gmrozek-mchp/wigwag/hardware/kicad/wigwag.kicad_sch

## KiCad design hardware/kicad/wigwag.kicad_sch (2026-08-15)

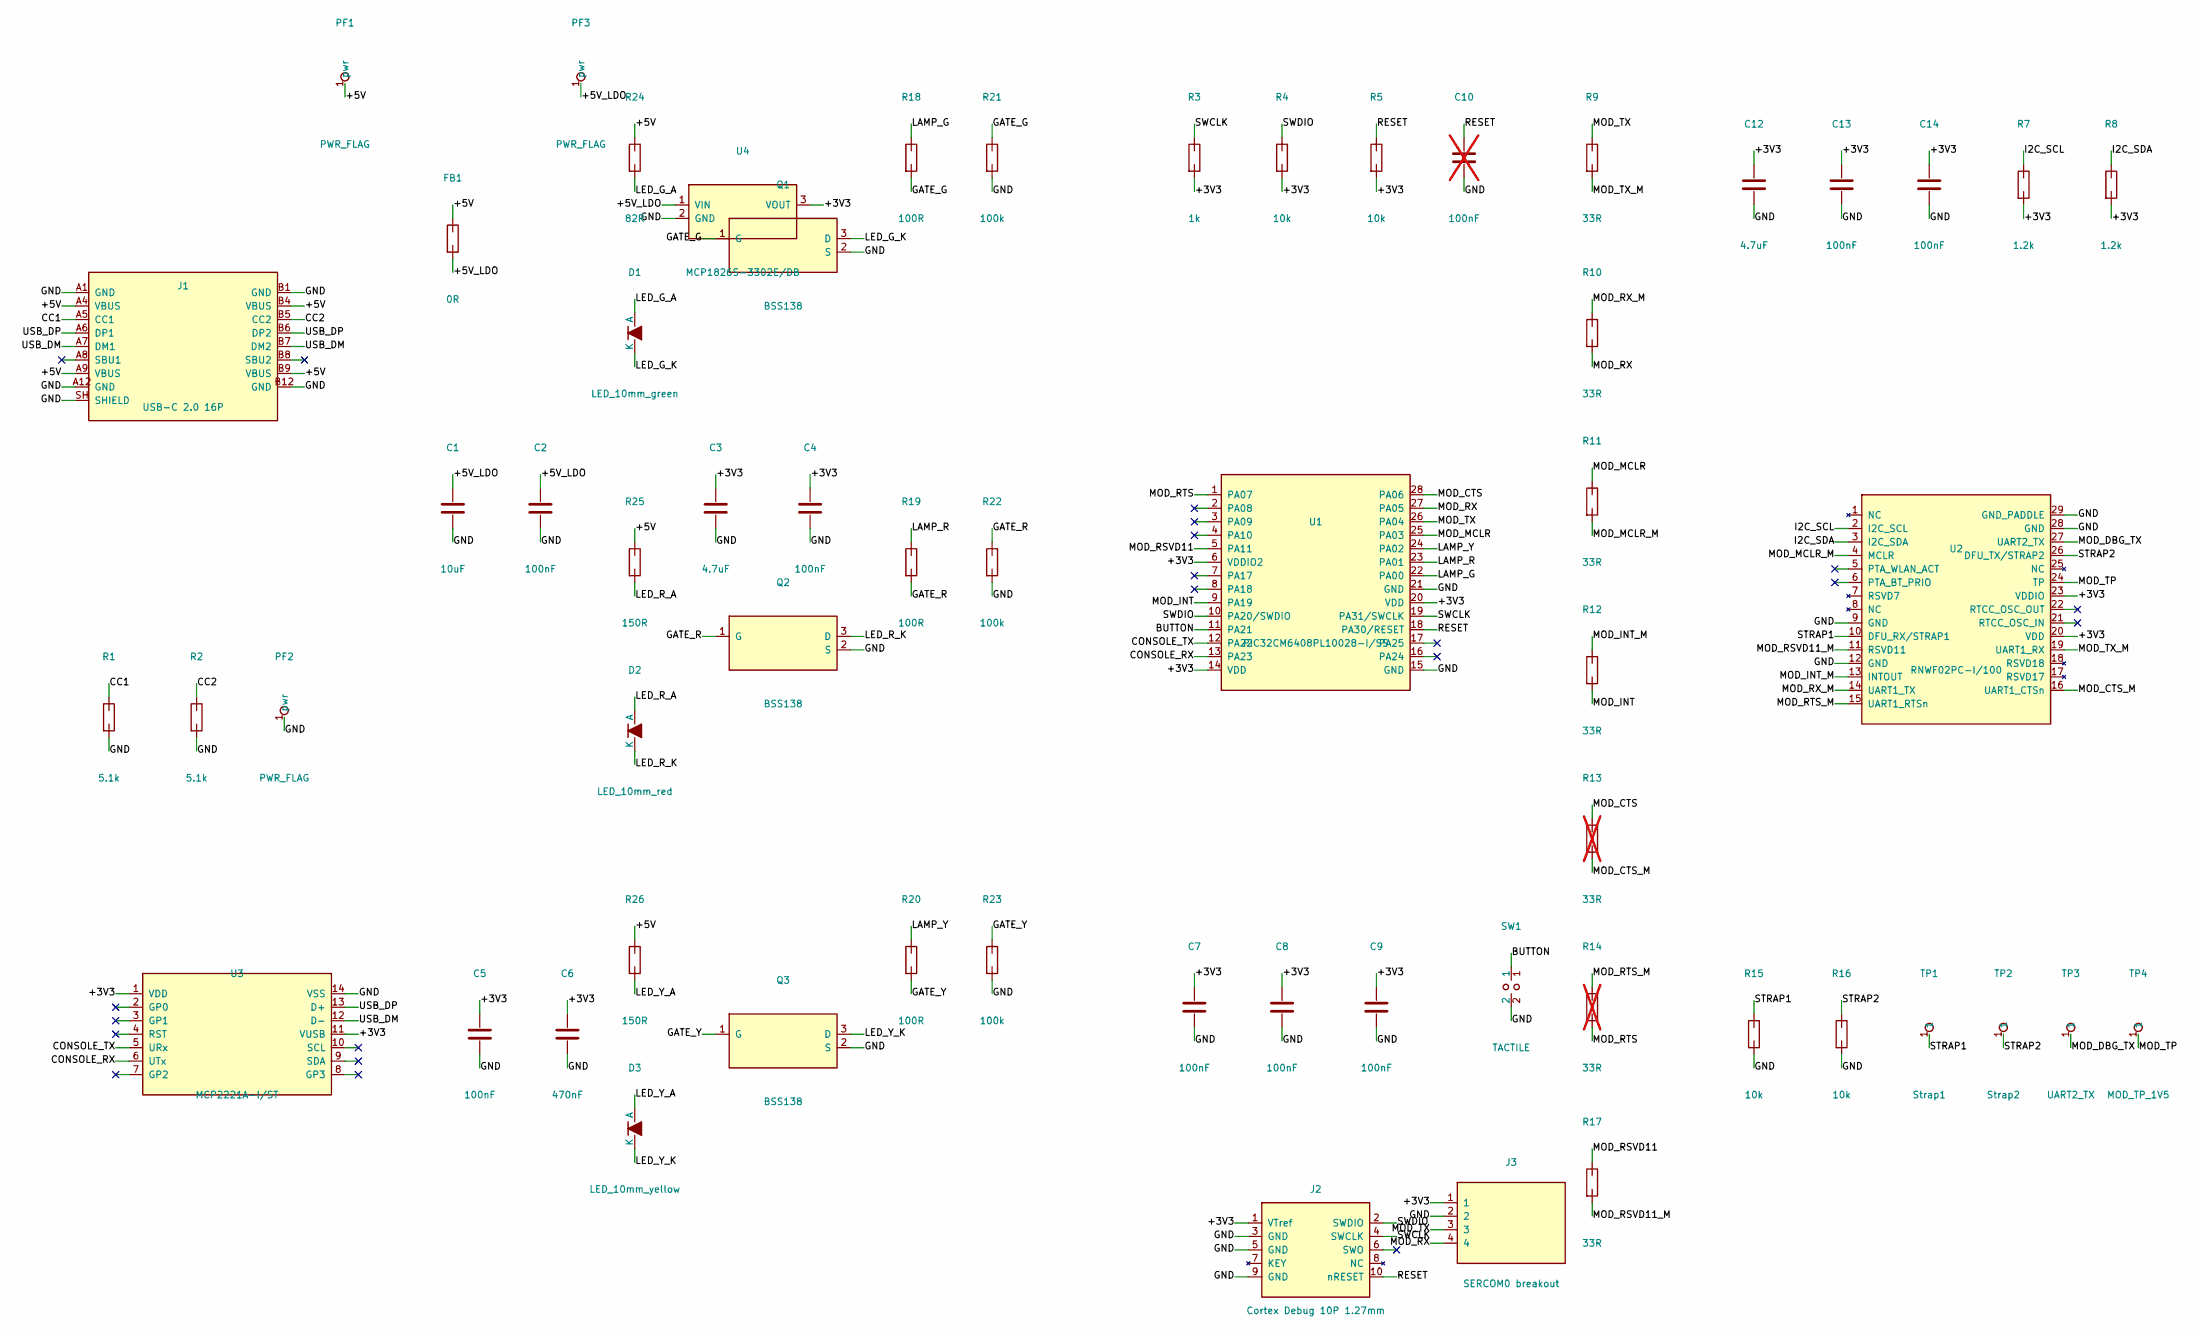
[picture p1: schematic wigwag.kicad_sch]

Parts:
C1: 10uF; C_1206_3216Metric
C2, C4, C5, C7, C8, C9, C13, C14: 100nF; C_0402_1005Metric
C3: 4.7uF; C_0805_2012Metric
C6: 470nF; C_0402_1005Metric
C10: 100nF; C_0402_1005Metric; not fitted
C12: 4.7uF; C_1206_3216Metric
D1: LED_10mm_green; LED_D10.0mm
D2: LED_10mm_red; LED_D10.0mm
D3: LED_10mm_yellow; LED_D10.0mm
FB1: 0R; R_0805_2012Metric
J1: USB-C 2.0 16P; USB_C_Receptacle_GCT_USB4105-xx-A_16P_TopMnt_Horizontal
J2: Cortex Debug 10P 1.27mm; PinHeader_2x05_P1.27mm_Vertical
J3: SERCOM0 breakout; PinHeader_1x04_P2.54mm_Vertical
PF1, PF2, PF3: PWR_FLAG
Q1, Q2, Q3: BSS138; SOT-23
R1, R2: 5.1k; R_0402_1005Metric
R3: 1k; R_0402_1005Metric
R4, R5, R15, R16: 10k; R_0402_1005Metric
R7, R8: 1.2k; R_0402_1005Metric
R9, R10, R11, R12, R17: 33R; R_0402_1005Metric
R13, R14: 33R; R_0402_1005Metric; not fitted
R18, R19, R20: 100R; R_0402_1005Metric
R21, R22, R23: 100k; R_0402_1005Metric
R24: 82R; R_0805_2012Metric
R25, R26: 150R; R_0805_2012Metric
SW1: TACTILE; SW_PUSH_6mm
TP1: Strap1; TestPoint_Pad_D1.5mm
TP2: Strap2; TestPoint_Pad_D1.5mm
TP3: UART2_TX; TestPoint_Pad_D1.5mm
TP4: MOD_TP_1V5; TestPoint_Pad_D1.5mm
U1: PIC32CM6408PL10028-I/SS; SSOP-28_5.3x10.2mm_P0.65mm
U2: RNWF02PC-I/100; RNWF02PC_Module
U3: MCP2221A-I/ST; TSSOP-14_4.4x5mm_P0.65mm
U4: MCP1826S-3302E/DB; SOT-223-3_TabPin2

Connections:
+3V3: C3.1, C4.1, C5.1, C6.1, C7.1, C8.1, C9.1, C12.1, C13.1, C14.1, J2.1 (VTref), J3.1, R3.2, R4.2, R5.2, R7.2, R8.2, U1.6 (VDDIO2), U1.14 (VDD), U1.20 (VDD), U2.20 (VDD), U2.23 (VDDIO), U3.1 (VDD), U3.11 (VUSB), U4.3 (VOUT)
+5V: FB1.1, J1.A4 (VBUS), J1.A9 (VBUS), J1.B4 (VBUS), J1.B9 (VBUS), PF1.1, R24.1, R25.1, R26.1
+5V_LDO: C1.1, C2.1, FB1.2, PF3.1, U4.1 (VIN)
BUTTON: SW1.1, U1.11 (PA21)
CC1: J1.A5 (CC1), R1.1
CC2: J1.B5 (CC2), R2.1
CONSOLE_RX: U1.13 (PA23), U3.6 (UTx)
CONSOLE_TX: U1.12 (PA22), U3.5 (URx)
GATE_G: Q1.1 (G), R18.2, R21.1
GATE_R: Q2.1 (G), R19.2, R22.1
GATE_Y: Q3.1 (G), R20.2, R23.1
GND: C1.2, C2.2, C3.2, C4.2, C5.2, C6.2, C7.2, C8.2, C9.2, C10.2, C12.2, C13.2, C14.2, J1.A1 (GND), J1.A12 (GND), J1.B1 (GND), J1.B12 (GND), J1.SH (SHIELD), J2.3 (GND), J2.5 (GND), J2.9 (GND), J3.2, PF2.1, Q1.2 (S), Q2.2 (S), Q3.2 (S), R1.2, R2.2, R15.2, R16.2, R21.2, R22.2, R23.2, SW1.2, U1.15 (GND), U1.21 (GND), U2.9 (GND), U2.12 (GND), U2.28 (GND), U2.29 (GND_PADDLE), U3.14 (VSS), U4.2 (GND)
I2C_SCL: R7.1, U2.2 (I2C_SCL)
I2C_SDA: R8.1, U2.3 (I2C_SDA)
LAMP_G: R18.1, U1.22 (PA00)
LAMP_R: R19.1, U1.23 (PA01)
LAMP_Y: R20.1, U1.24 (PA02)
LED_G_A: D1.1 (A), R24.2
LED_G_K: D1.2 (K), Q1.3 (D)
LED_R_A: D2.1 (A), R25.2
LED_R_K: D2.2 (K), Q2.3 (D)
LED_Y_A: D3.1 (A), R26.2
LED_Y_K: D3.2 (K), Q3.3 (D)
MOD_CTS: R13.1, U1.28 (PA06)
MOD_CTS_M: R13.2, U2.16 (UART1_CTSn)
MOD_DBG_TX: TP3.1, U2.27 (UART2_TX)
MOD_INT: R12.2, U1.9 (PA19)
MOD_INT_M: R12.1, U2.13 (INTOUT)
MOD_MCLR: R11.1, U1.25 (PA03)
MOD_MCLR_M: R11.2, U2.4 (MCLR)
MOD_RSVD11: R17.1, U1.5 (PA11)
MOD_RSVD11_M: R17.2, U2.11 (RSVD11)
MOD_RTS: R14.2, U1.1 (PA07)
MOD_RTS_M: R14.1, U2.15 (UART1_RTSn)
MOD_RX: J3.4, R10.2, U1.27 (PA05)
MOD_RX_M: R10.1, U2.14 (UART1_TX)
MOD_TP: TP4.1, U2.24 (TP)
MOD_TX: J3.3, R9.1, U1.26 (PA04)
MOD_TX_M: R9.2, U2.19 (UART1_RX)
RESET: C10.1, J2.10 (nRESET), R5.1, U1.18 (PA30/RESET)
STRAP1: R15.1, TP1.1, U2.10 (DFU_RX/STRAP1)
STRAP2: R16.1, TP2.1, U2.26 (DFU_TX/STRAP2)
SWCLK: J2.4 (SWCLK), R3.1, U1.19 (PA31/SWCLK)
SWDIO: J2.2 (SWDIO), R4.1, U1.10 (PA20/SWDIO)
USB_DM: J1.A7 (DM1), J1.B7 (DM2), U3.12 (D-)
USB_DP: J1.A6 (DP1), J1.B6 (DP2), U3.13 (D+)
