gmrozek-mchp/wigwag/(commit log)

2026-08-14 Phase 0: project scaffold, journaling workflow, and nine ADRs
    wigwag is a Wi-Fi desk stoplight that shows AI coding session state:
    green idle, yellow working, red waiting on you. Microchip silicon,
    Zephyr RTOS, custom PCB, 3D-printed enclosure.
    No code yet — this establishes the documentation practice first, which
    was the project's stated first rule.
    Documentation structure (ADR-0005):
    - JOURNAL.md append-only devlog, newest first
    - docs/adr/ one durable decision per numbered file
    - CONTEXT.md ubiquitous language; states are IDLE/BUSY/WAIT/ERROR
    - CLAUDE.md five standing rules for AI-assisted sessions
    - docs/PLAN.md the plan plus a D01-D51 decision register
    Reusable journal sk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
2026-08-14 Phase 1: host daemon, CLI, and cross-platform hook client
    Claude Code hooks -> wg-notify -> wigwagd -> MQTT broker -> the light.
    93 tests, no hardware required.
    Two added requirements invalidated parts of the approved plan:
    Cross-platform. The plan's AF_UNIX datagram socket does not exist on
    Windows, and its `sh` + `nc` client is unusable (no nc in Git Bash, and
    incompatible flags across netcat variants). Replaced with loopback UDP
    and a shell client using bash's built-in /dev/udp: no jq, sed, nc,
    Python or Node in the hook path, measured at 2.9 ms median / 3.7 ms p95.
    UDP also makes Rule 3 structural rather than careful, since sendto on a
    connectionless socket cannot block or fail when th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
    [__main__.py, cli.py, config.py, daemon.py, listener.py, paths.py, protocol.py, publisher.py]
2026-08-14 ADR-0013: the broker address is configured, not auto-discovered
    Resolves D60, left open by ADR-0012.
    DNS-SD does register service names for this — _mqtt._tcp (1883) and
    _secure-mqtt._tcp (8883) — but neither end of this system speaks it,
    and both were verified rather than assumed:
    - RNWF02 has no mDNS. Its network features are listed identically in
    the datasheet and sell sheet: TCP, UDP, DHCP, ARP, HTTP, MQTT,
    IPv4/IPv6, TLS 1.2, DNS, SNTP.
    - mosquitto does not advertise: no mDNS/avahi symbols in the binary,
    and a live `dns-sd -B _mqtt._tcp local` browse returned nothing.
    Two naming collisions kept distinct in the ADR, since both mislead:
    Harmony 3's TCPIP_MDNS_ServiceRegister b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
2026-08-14 Phase 2: Zephyr workspace, and D49 TCC0 PWM passes on hardware
    Pinned minimal west workspace with its top directory at the repo root
    (ADR-0014): mainline at an explicit SHA per ADR-0006, a four-module
    name-allowlist, and the arm-zephyr-eabi toolchain only. ~1 GB of tree and one
    toolchain rather than several gigabytes of both.
    D49, the spike gating the PCB, passes in devicetree alone. Mainline has the
    driver and the binding, but the PL10 devicetree defines no TC or TCC node at
    all, so nothing bound. firmware/boards/pic32cm_pl10_cnano.overlay adds TCC0,
    its generic-clock channel and its pinctrl group; no driver work, no patch to
    the pinned tree, no Zephyr4Microchip fallback.
    Verified on an E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
    [main.c]
2026-08-14 Capture the RNWF02 AT wire vocabulary, verified from the specification
    firmware/src/rnwf_at_cmds.h holds every command string, parameter ID and
    length limit the firmware needs, each cited to the AT Command Specification,
    Network Controller 3.1.0, Revision 58a15dc2, August 19 2025.
    Needed because the MCP documentation tools cannot see that specification at
    all: MQTT queries return only the Harmony 3 C wrapper, which documents
    semantics and no wire text. Deliberately not derived from the RNWF11 guide's
    inline AT reference either - assuming a sibling module's command set is how a
    plausible fiction gets encoded, and a fake module built on one would pass its
    own tests while proving nothing.
    Fou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
2026-08-14 AT client core, with host tests that need neither Zephyr nor hardware
    firmware/src/rnwf_at.{h,c}: line assembler, request/response engine, AEC
    dispatch, connect state machine with capped exponential backoff, publish. No
    Zephyr headers, no allocation, one bounded buffer per direction.
    The connect sequence is a script - an array of steps, each with a command
    builder and an optional AEC to await - rather than a state per command. That
    makes the specification's most dangerous rule structural instead of remembered:
    OK means accepted, not done, so a step that awaits an AEC does not advance when
    OK arrives. A builder returning 0 means "skip me", which handles NULL
    credentials and open networks wit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
    [rnwf_at.c, rnwf_at.h]
2026-08-14 Fake RNWF02 module and host runner: end-to-end AT client, no hardware
    firmware/sim/fake_rnwf02.py speaks the AT protocol on a PTY or serial port and
    bridges MQTT to a real broker. Framing is faithful to the specification,
    including the leading CR on every AEC and the rule that AECs queue behind a
    command in flight rather than interleaving with it. Failure injection covers
    what a real module will never do on demand: --no-connack, --connack-reason,
    --fail <PREFIX>, --drop-link-after, --slow.
    firmware/sim/at_host.c drives the real rnwf_at.c over that PTY via
    "make -C firmware/tests sim". Together these are the native_sim substitute
    ADR-0015 promised, and they work on macOS.
    Verified against a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
    [at_host.c, fake_rnwf02.py, rnwf_at.c, rnwf_at.h]
2026-08-14 Fix inverted lamp polarity, and the binding bug that made the fix a no-op
    The Curiosity Nano's LED0 is active low - user guide Table 4-1 and section
    4.1, "driving the connected I/O line to GND will activate the LED" - while
    mainline's pic32cm_pl10_cnano.dts declares it GPIO_ACTIVE_HIGH. The D49 lamp
    had therefore been running inverted, and neither blinky nor a symmetric fade
    can reveal that, since an inverted triangle is still a triangle. The cubic
    gamma ramp is what distinguishes the two: with the wrong polarity the lamp sat
    lit with a brief dark dip, the exact inverse of a breath.
    Adding PWM_POLARITY_INVERTED changed the generated devicetree but produced a
    byte-identical binary, which pyO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
    [main.c]
2026-08-14 Document how to upstream the two Zephyr bugs found in Phase 2
    docs/upstreaming-to-zephyr.md captures the submission process so it does not
    have to be re-derived: issue first, fork, git commit -s with a legal name,
    subject under 72 characters, mandatory body even for a one-liner, Fixes #N,
    rebase rather than fixup. Read from the Zephyr contribution docs rather than
    recalled, with the pages cited.
    Also records what routing and evidence a reviewer will want: both files sit in
    the MAINTAINERS.yml "Microchip PIC32 Platforms" area; the binding rename is safe
    because pwm-cells are positional and nothing in tree reads the cell by name; and
    the four in-tree users of those bindings are unaffected. Re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
2026-08-14 SERCOM0 transport: the AT client now runs the full script on silicon
    Enables SERCOM0 as the module UART in the board overlay - pinctrl group,
    gclkperiph channel, microchip,sercom-g1-uart node - behind a wigwag,module-uart
    chosen node so the AT client never names a board-specific label. PA04 is PAD0
    (TX) and PA05 is PAD1 (RX), mux C, chosen by elimination: the debugger holds
    PB00/PB01, PA20, PA31, PB03 and PA30; PA24/PA25 are the crystal footprint;
    PB08/PB09 the touch button; and PA08-PA15 sit in the MVIO domain (D76).
    firmware/src/rnwf_uart.{h,c} is the Zephyr half of struct rnwf_at_io:
    interrupt-driven receive into a 256-byte static ring drained in thread context,
    polled transmit. Polled r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
2026-08-14 link.c: supervise the link so the device cannot confidently lie
    Built before lamp.c on purpose. Until supervision exists a renderer can only
    produce a confident display of something nobody is confirming, so building the
    lamps first would have meant building the ability to lie and then fixing it.
    Reading +MQTTCONN:<CONN_STATE> - the last unread part of the AT specification -
    made the structure clear. There are three independent ways to lose the truth and
    no single signal covers them:
    module or UART dies nothing arrives keepalive AT goes unanswered
    broker or Wi-Fi lost module still healthy module reports +MQTTCONN:0
    host daemon dies module and broker ok wigwag/host_onlin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
    [link.c, link.h, main.c, rnwf_at.c, rnwf_at.h, rnwf_at_cmds.h]
2026-08-14 Measure stack utilisation, and tune the ISR stack on the evidence
    Stack sizes were the one part of this budget chosen by feel, which Rule 5 asks
    us not to do. firmware/prj_stacks.conf is a measurement-only overlay:
    CONFIG_THREAD_ANALYZER selects CONFIG_INIT_STACKS, which fills every stack with
    0xaa before use - threads and the interrupt stack alike - and the analyzer walks
    each one to find where the pattern stops. Output goes through printk so it does
    not drag in the logging subsystem, and CONFIG_THREAD_NAME is enabled because
    without it the report prints thread-object addresses instead of names.
    Peaks after an exercise covering the connect script, every lamp behaviour, an
    unparseable paylo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
2026-08-14 Three lamps: CONTEXT.md's table becomes executable, and two faults found doing it
    lamp.c holds the animation as pure logic - (state, link condition, time) ->
    three perceptual levels, plus a state parser and the gamma curve - with
    lamp_pwm.c as the Zephyr renderer owning PWM, per-lamp polarity and a render
    thread. Same core/adapter split as rnwf_at.c against rnwf_uart.c, so every
    behaviour in CONTEXT.md's lamp table is asserted on the host: 511 checks,
    bringing the three suites to 1407.
    Pins on the Curiosity Nano, by elimination: green on WO0/PA24, red on WO1/PA25,
    yellow on WO2/PB02 which is the board's own LED. PA24/PA25 are the 32.768 kHz
    crystal's I/O lines, which the board routes to the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
2026-08-14 button.c: publish presses, and the device talks back for the first time
    button.c is pure debounce and press classification - 20 ms settling, duration
    measured between debounced edges, long-hold threshold at 3 s - with
    button_gpio.c as a polled pin read. test_button.c adds 23 checks; four suites
    now total 1430.
    Polled rather than interrupt-driven, which deviates from plan item 17's "GPIO
    IRQ" (D86). The GPIO driver does support interrupts, but only through
    CONFIG_INTC_MCHP_EIC_G1, and PL10's devicetree has no eic node - the driver and
    binding exist and the JH, SG and SAM families instantiate it, but this family
    does not. The same three-layer gap as TCC0. Polling wins on merit anyway: a
    press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
    [button.c, button.h, button_gpio.c, button_gpio.h, main.c]
2026-08-14 Brightness in two layers: preference over MQTT, calibration in devicetree
    Asked whether brightness should be one value or per bulb; it is both, at
    different layers, because they are different problems. wigwag/brightness is
    runtime preference - "too bright for my desk at night" - carried retained over
    MQTT as CONTEXT.md specifies. Per-lamp gain is calibration, a fixed property of
    a board and its parts, sitting in devicetree beside polarity. LEDs of different
    colours are not equally efficient at the same duty, so equal perceptual levels
    do not look equally bright.
    Sharing one mechanism would give the worst of both: calibration clobbered
    whenever somebody dims the device for the evening, and a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
    [lamp.c, lamp.h, lamp_pwm.c, lamp_pwm.h, main.c, rnwf_at.c, rnwf_at.h]
2026-08-15 Publish wigwag/online, and verify the Last Will actually fires
    main.c publishes 1 retained to wigwag/online once per connection, closing the
    last gap in CONTEXT.md's topic table. AT+MQTTLWT had registered 0 as the will
    since the AT client was written, but a will with no positive counterpart is
    useless: a subscriber cannot distinguish "never seen" from "connected", because
    both look like an absent topic.
    Keyed on the AT client reaching READY, deliberately not on the link condition.
    This topic means "connected to the broker", which stays true when the host daemon
    dies; publishing 0 then would be the device misreporting itself because somebody
    else went away. wigwag/online is the device's own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
    [main.c]
2026-08-15 firmware: watchdog that only feeds when every task is alive
    Both the AT service loop and the render thread must check in within
    500 ms or the device stops feeding and the WDT reboots it 2 s later.
    Feeding from one loop would have certified half the system while
    silently vouching for the other half: the render thread could die
    with the lamps frozen on a stale state and the watchdog would keep
    the device up indefinitely. Demonstrated on hardware by wedging the
    render thread deliberately. ADR-0016, D93-D95.
    Liveness accounting is pure logic in wdog.c, host-tested (6159
    checks); wdog_wdt.c holds the peripheral and the reset-cause report.
    Adds the wdt and rstc devicetree nodes PL10 lacks.
    CON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
    [lamp_pwm.c, main.c, wdog.c, wdog.h, wdog_wdt.c, wdog_wdt.h]
2026-08-15 firmware: flash driver for PL10's NVMCTRL, as a Zephyr module
    Mainline has no flash driver for PIC32CM PL, and its two Microchip
    drivers target other peripheral revisions: nvmctrl-g1-flash names
    module U2409 and drives a page buffer with PBC/EB, which this
    revision does not have. Written from the datasheet sequence
    (26.4.2.3.4) and verified on a pic32cm_pl10_cnano.
    Shipped as an out-of-tree module rather than a patch to the pinned
    tree, since west update reverts patches silently, and because this
    shape upstreams as a file move. ADR-0017, D96-D99.
    The subtlety worth knowing: issuing an enable command such as FLWR
    or FLPER is itself a command that clears INTFLAG.READY, and storing
    to the a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
2026-08-15 Fit an MCP2221A, and run one transport at a time
    Decides the two questions left open yesterday. The MCP2221A goes on
    the USB-C connector ADR-0009 already puts on the board for power with
    D+/D- unconnected, so the delta is one TSSOP-14, two caps and two
    pins -- it carries its own oscillator and USB termination.
    That preserves the console on the product. Not a new capability: the
    Curiosity Nano's debugger already supplies a CDC console and the
    firmware has been built assuming one. The point is that it would
    silently disappear on a board with no debugger attached, leaving SWD
    as the only route to RESET BY WATCHDOG, NOT FEEDING, link UNLINKED
    and the D74 PWM flags. Carrying it over is a dev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
2026-08-15 firmware: configure the device over the console
    Changing a Wi-Fi password needed a rebuild and a probe (D56). Now the
    network, broker, per-lamp calibration and brightness are set over the
    console and stored in the partition ADR-0017's flash driver made
    writable; Kconfig supplies defaults only. ADR-0019, D105-D110.
    Hand-rolled in three layers so the editing half can be replaced:
    lineedit.c (bytes -> lines, injected output callback, no Zephyr),
    cmd.c (vocabulary and validation), console.c (effects). Zephyr's
    shell was measured and does not link on this part -- RAM overflowed
    by 464 bytes, ~4 KB against 3624 free -- and embedded-cli was
    assessed and declined. Backspace kept; arrow keys mad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
    [cmd.c, cmd.h, console.c, console.h, lamp.c, lamp.h, lamp_pwm.c, lamp_pwm.h]
2026-08-15 firmware: one transport at a time, chosen from evidence
    Implements D104. transport.c sits above link.c: link.c answers "is the
    Wi-Fi path trustworthy", transport.c answers "which path is the device
    listening to, and may it be believed". The lamps follow the transport,
    so a trusted USB host outranks a healthy Wi-Fi link and a quiet USB
    host goes fail-visible even while Wi-Fi is up.
    Checking the daemon first turned up the reason the wired path needs
    something MQTT does not: host_online is published once, retained, with
    0 as the Last Will, so the broker holds the value and reports the
    death. A serial line has neither, and USBCFG cannot help because a
    machine whose daemon crashed still enume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
    [cmd.c, cmd.h, console.c, console.h, main.c, transport.c]
2026-08-15 host: publish over a serial wire, not just a broker
    Completes D111, which was device-side only. A SerialPublisher sits
    behind the Publisher protocol the daemon already had, so a device wired
    to this machine needs no broker, no Wi-Fi credentials and no
    provisioning. Verified end to end: hook UDP -> daemon -> serial ->
    device, with the device reporting `transport usb TRUSTED`.
    pyserial on every platform rather than termios on POSIX and pyserial on
    Windows. A split backend puts the untested path on the platform we
    cannot casually debug, and saves nothing since Windows needs the
    dependency either way. Optional extra, imported lazily, so the test
    suite and pure logic still run with nothing i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
    [__main__.py, config.py, publisher.py]
2026-08-15 firmware: the USB claim latches until reset
    Supersedes ADR-0018's transport-selection mechanics and its
    USBCFG/SSPND pin decision. ADR-0021, D117, D118; D112 superseded.
    The soft hold treated the two transports as interchangeable carriers of
    one truth. They are not: a daemon aggregates the sessions of its own
    machine (D30), so falling back from USB to Wi-Fi does not restore the
    display -- it silently changes the subject from "what is my laptop
    doing" to "what is some other machine doing", with nothing on a
    three-lamp device to mark the swap. Amber is the more honest answer.
    So once a host has spoken over the wire, the device belongs to USB for
    the rest of the boot. Trust still tracks t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
    [cmd.c, cmd.h, console.c, main.c, transport.c, transport.h]
2026-08-15 host: report the transport in use, not the broker
    `wigwag status` printed "broker localhost:1883 (plain)" while
    publishing over a serial wire, and `wigwag config` printed broker
    settings -- and broker warnings -- for a device that had no broker. A
    status display that misdescribes the system invites debugging the wrong
    half of it.
    The snapshot now carries a `transport` label taken from the live
    configuration, and the config printer shows only the transport in use.
    Found by bringing the whole stack up against real Claude Code hook
    events rather than synthetic datagrams, which the journal entry
    records: both paths carried this session's own state, and an
    accidentally stale `broker mqtt.home.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
    [cli.py, daemon.py]
2026-08-15 firmware: the transport is configured, not inferred
    Supersedes ADR-0021 outright and the rest of ADR-0018's selection
    decision. ADR-0022, D119, D120; D104, D112 and D117 superseded, D103
    withdrawn.
    Selection was inference (D104), then inference plus a latch (D117).
    Both let a cable plugged in for power or configuration silently
    repurpose the device, and the latch made it irreversible as well as
    surprising. The mistake in both was treating the choice as something
    to detect: ADR-0013 had already settled this shape for the broker
    address -- configured, not auto-discovered -- and this should have
    followed it.
    So `set transport usb|wifi`, stored, shown first by `show` because it
    decides what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
    [cmd.c, cmd.h, console.c, main.c, settings.c, settings.h, settings_store.c]
2026-08-15 firmware: test wifi before committing to it, and a real wigwag
    Two changes that turned out to be connected. D121, D122.
    `test wifi` runs the connect script against the stored settings on a
    device that is still wired, names the step it reaches, and leaves the
    transport setting and the lamps alone. Previously the only way to test
    Wi-Fi was `set transport wifi`, `save`, `reboot`, and then staring at a
    device that would not say why it failed. rnwf_at.c's script table
    gained a name per step, so a wrong passphrase fails at "associate and
    get an IP", a wrong broker at "resolve, connect and CONNACK", and a
    miswired module at "module responding".
    It runs asynchronously, advanced by the service l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
    [at_host.c, cmd.c, cmd.h, console.c, console.h, lamp.c, lamp.h, link.c]
2026-08-15 hardware: the 28-pin pin assignment, and one forced pin
    Phase 3 opens with the pin map, because layout, the enclosure's lamp pitch
    and the product devicetree all derive from it, and because D101 established
    that the cnano's map does not transfer.
    Two findings changed the answer, and both mean D101 was incomplete:
    Its lamp/console overlap is not real. That holds only if a USART's TxD must
    sit on PAD[0], and §29.6.1 says otherwise — CTRLA.TXPO = 0x1 selects
    PAD[2] = TxD, with RXPO picking any pad independently. The second pair
    reaches PA22/PA23, two pads with no TCC0 and no SERCOM0 function at all,
    so the contention dissolves rather than being traded off. Devicetree only:
    mainline's drive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
2026-08-15 hooks: WAIT had never once fired
    The Notification hook used one combined matcher,
    "permission_prompt|idle_prompt|agent_needs_input", but matchers filter
    on the notification type and no type contains a pipe -- so it matched
    nothing, and the only state that asks for the user's attention has been
    unreachable since Phase 1. Fixed with the documented PermissionRequest
    event plus one matcher per type. D123.
    Nothing but real use could have found this: every test asserts on what
    happens given a SET WAIT datagram, and the datagram was never sent.
    Once fixed, LAMP_WAIT_ESCALATE_MS ran on hardware for the first time.
    Denying then left the lamps red, which turns out not to be a defect.
    PermissionDen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
2026-08-15 hardware: the ground plane is the antenna, and bulk capacitance has a ceiling
    Plan item 21 — stackup, placement, four-layer antenna keepout. L2 solid and
    unbroken as the sole reference plane; module at the top edge with the antenna
    overhanging a 5.3 x 15.73 mm all-layer keepout; every noise source at the base,
    which is also why the magnets are there. Board sized ~40 x 85 mm on the
    datasheet's own 45%-vs-69% efficiency measurement.
    "Add bulk capacitance for TX peaks" was not available: VBUS is the LDO input
    and the 3V3 net its output, so the USB inrush ceiling and MCP1826 4.4 cap total
    3V3 capacitance near 10 uF. Whether that survives a 311 mA burst is measured,
    not calculated — 1206 pad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
2026-08-15 hardware: the net-level schematic spec, and a board that works without the radio
    Item 20's spec — every part, pin and net across five blocks on the 11x17 sheet.
    D137-D140.
    Reading the complete Table 2-1 turned up three gaps: module pin 11 carries a
    "do not leave unconnected" instruction that a test point does not satisfy, so it
    takes PA11 tri-stated and retires the PA10+PA11 swap; the RTCC mount option is
    declined on the record rather than omitted; and the FET gates had no pulldowns,
    so all three lamps floated from POR until firmware drove them.
    Debug is a 10-pin Cortex Debug header, not the 5-pin ICSP first specified: the
    PICkit Cortex SWD mapping puts SWDIO on pin 8 and SWO on pin 4, s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
2026-08-15 hardware: generate the schematic, and let KiCad check it
    The netlist lives beside the spec in gen_schematic.py; connectivity is by net
    label on a stub, so placement is cosmetic and cannot break the netlist, and a
    value change is one line plus a regenerate. D141.
    ERC went 350 -> 1 on KiCad 10.0.5 (not the 9 the plan assumed). The remaining
    violation is the module footprint, which item 22 has to draw. Off-grid origins,
    unresolvable lib_ids, and NC-type pins that must be left bare accounted for 348
    of the rest; +5V_LDO needed its own power flag because FB1 splits it from +5V.
    Corrects SCHEMATIC.md: datasheet-NC pins get no flag, only the functional pins
    we decline to use do. Also caught a 4th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
    [wigwag.kicad_sch]
